mfacton/traction-control/pcb/test-meter/Wiring.png

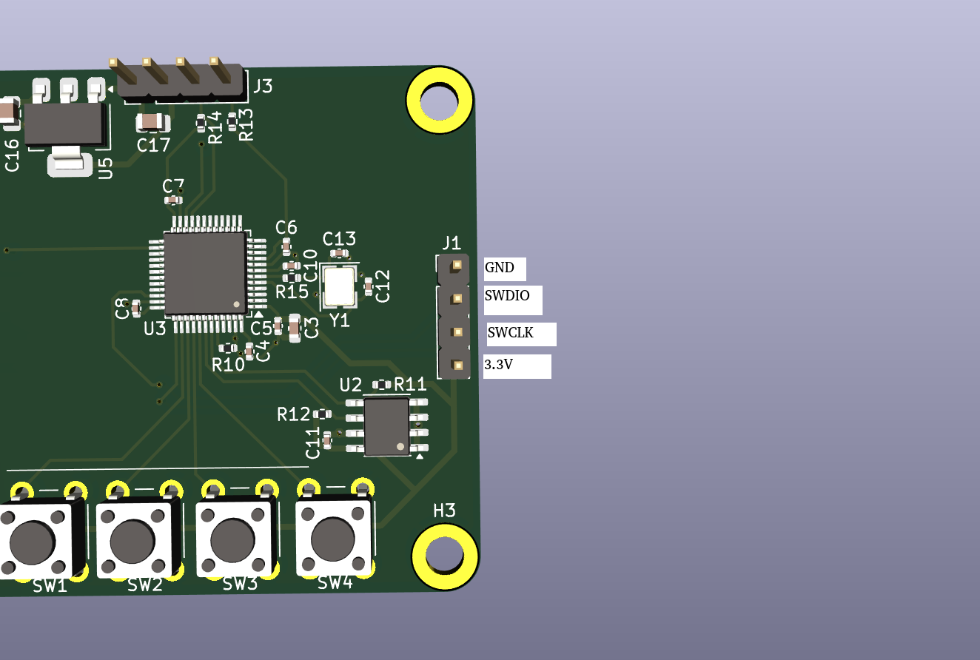
pcb/test-meter/Wiring.png
