mfacton/traction-control/notes.txt

gps should be powered off of 5V
put a diode to not drain the coincell
