mfacton/traction-control/pcb/traction-control/traction-control.kicad_pcb

## KiCad design pcb/traction-control/traction-control.kicad_pcb (2024-07-23)

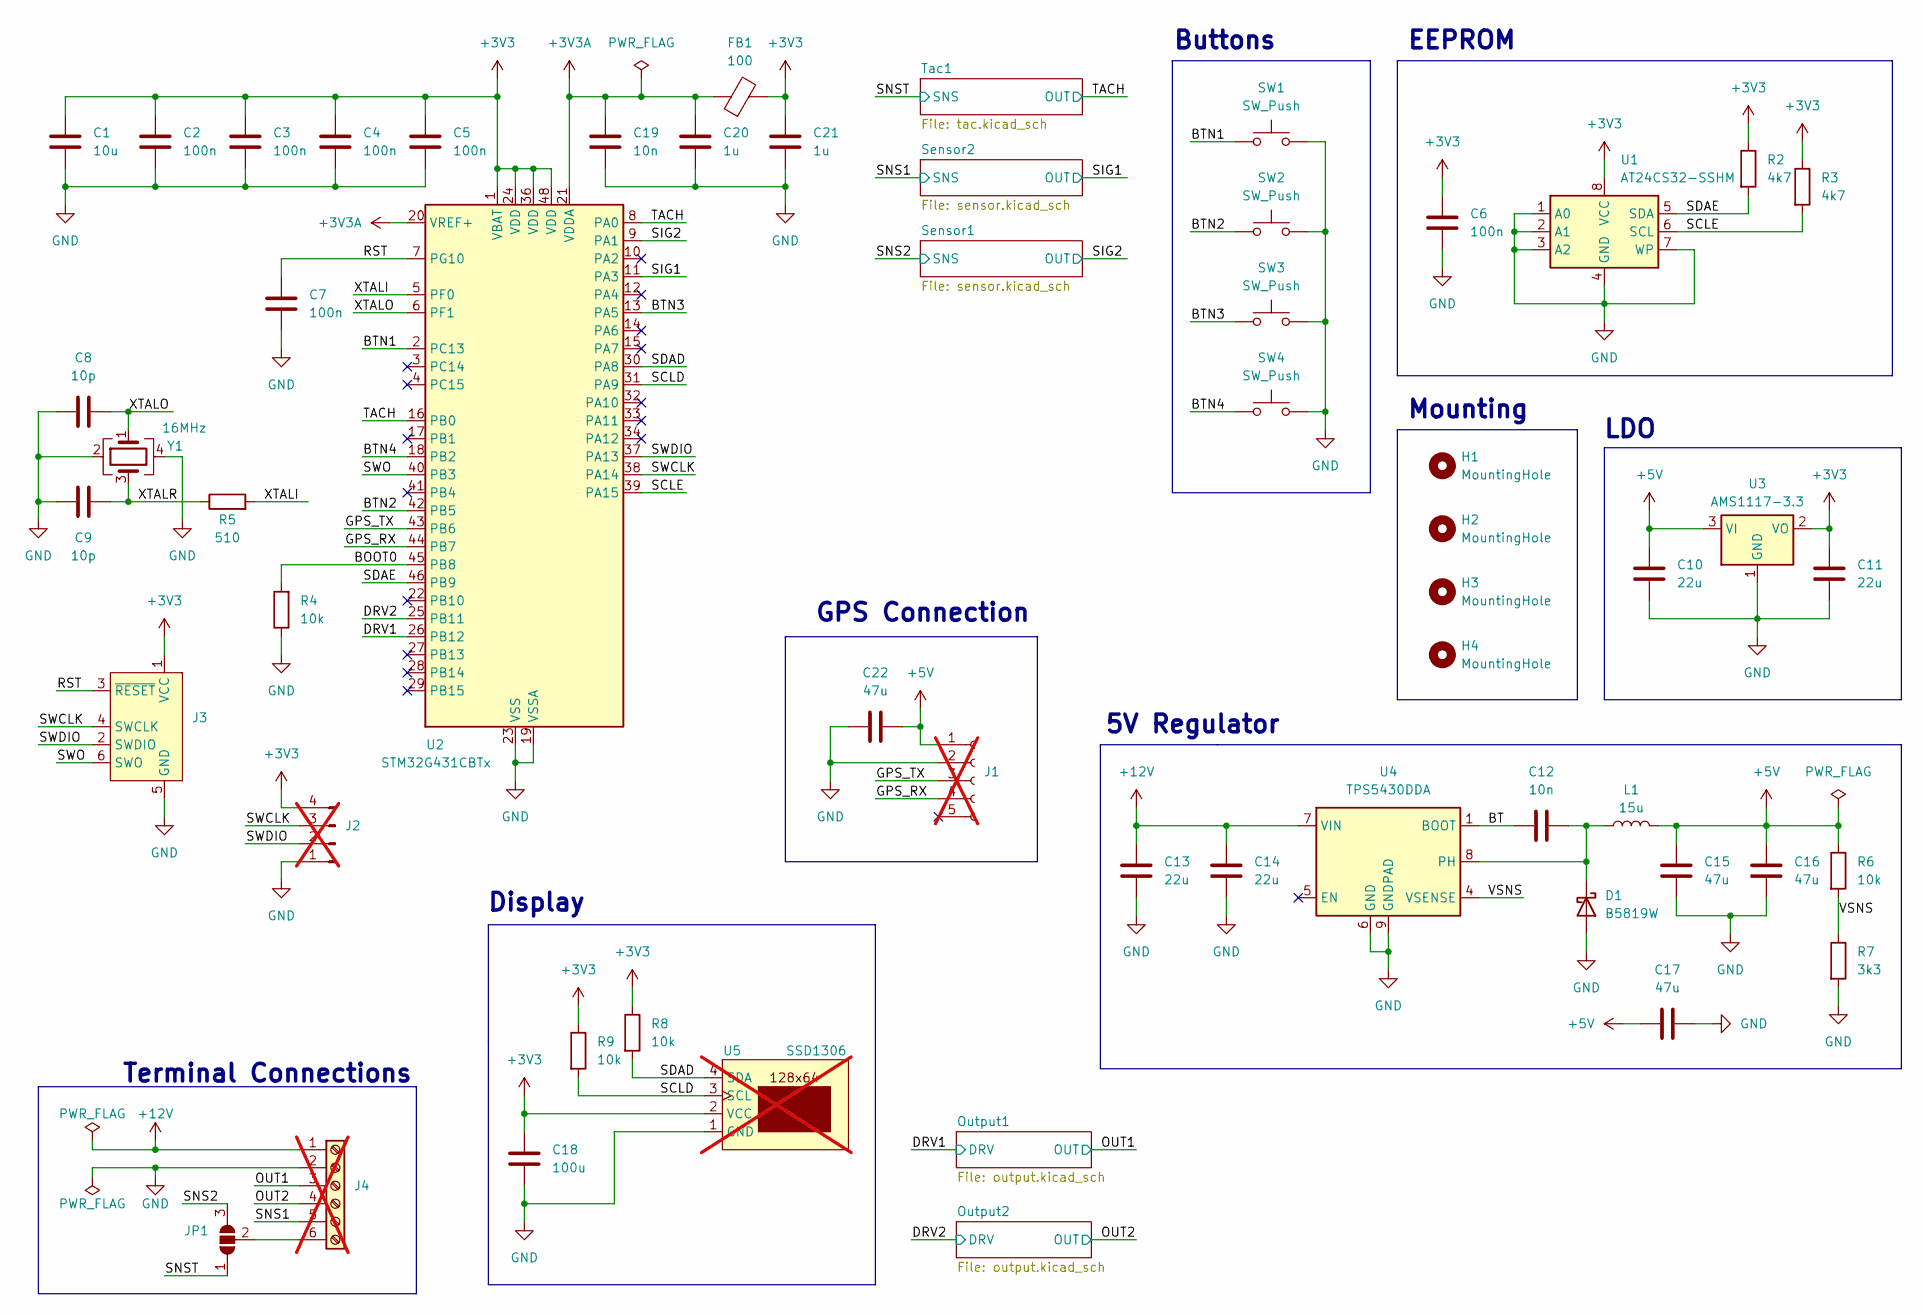
[picture p2: schematic traction-control.kicad_sch]

Parts:
C1: 10u; C_0402_1005Metric; LCSC C15525
C2, C3, C4, C5, C6, C7: 100n; C_0402_1005Metric; LCSC C1525
C8, C9: 10p; C_0402_1005Metric; LCSC C32949
C10: 22u; C_0805_2012Metric; LCSC C45783
C11: 22u; C_0603_1608Metric; LCSC C59461
C12, C19: 10n; C_0402_1005Metric; LCSC C15195
C13, C14: 22u; C_1206_3216Metric; LCSC C12891
C15, C16, C17, C22: 47u; C_1206_3216Metric; LCSC C96123
C18: 100u; C_1206_3216Metric; LCSC C15008
C20, C21: 1u; C_0402_1005Metric; LCSC C52923
D1: B5819W; D_SOD-123; LCSC C8598
FB1: 100; L_0805_2012Metric; LCSC C1015
H1, H2, H3, H4: MountingHole; MountingHole_3.2mm_M3
J1: Conn_01x05_Socket; PinHeader_1x05_P2.54mm_Vertical; not fitted
J2: Conn_01x04_Pin; PinHeader_1x04_P2.54mm_Vertical; not fitted
J3: Conn_ARM_SWD_TagConnect_TC2030-NL; Tag-Connect_TC2030-IDC-NL_2x03_P1.27mm_Vertical
J4: Screw_Terminal_01x06; ScrewTerminalPlug_6P_P5.08; not fitted
JP1: SolderJumper_3_Open; SolderJumper-3_P1.3mm_Open_RoundedPad1.0x1.5mm
L1: 15u; L_Changjiang_FNR6020S; LCSC C168015
R2, R3: 4k7; R_0402_1005Metric; LCSC C25900
R4, R6, R8, R9: 10k; R_0402_1005Metric; LCSC C25744
R5: 510; R_0402_1005Metric; LCSC C25123
R7: 3k3; R_0402_1005Metric; LCSC C25890
SW1, SW2, SW3, SW4: SW_Push; SW_Push_1P1T_NO_6x6mm_H9.5mm; LCSC C455119
U1: AT24CS32-SSHM; SOIC-8_3.9x4.9mm_P1.27mm; LCSC C6482
U2: STM32G431CBTx; LQFP-48_7x7mm_P0.5mm; LCSC C529355
U3: AMS1117-3.3; SOT-223-3_TabPin2; LCSC C6186
U4: TPS5430DDA; TI_SO-PowerPAD-8_ThermalVias; LCSC C9864
U5: SSD1306; SSD1309_1.3; not fitted
Y1: 16MHz; Crystal_SMD_3225-4Pin_3.2x2.5mm; LCSC C13738

Connections:
+3V3: C1.1, C2.1, C3.1, C4.1, C5.1, C6.1, C11.1, C18.1, C21.1, FB1.2, J2.4, J3.1 (VCC), R2.1, R3.1, R8.1, R9.1, U1.8 (VCC), U2.1 (VBAT), U2.24 (VDD), U2.36 (VDD), U2.48 (VDD), U3.2 (VO), U5.2 (VCC)
+3V3A: C19.1, C20.1, FB1.1, U2.20 (VREF+), U2.21 (VDDA)
+5V: C10.1, C15.1, C16.1, C17.1, C22.1, J1.1, L1.2, R6.1, U3.3 (VI)
+12V: C13.1, C14.1, J4.1, U4.7 (VIN); also elsewhere on the board
/BOOT0: R4.2, U2.45 (PB8)
/BT: C12.1, U4.1 (BOOT)
/BTN1: SW1.1, U2.2 (PC13)
/BTN2: SW2.1, U2.42 (PB5)
/BTN3: SW3.1, U2.13 (PA5)
/BTN4: SW4.1, U2.18 (PB2)
/DRV1: U2.26 (PB12); also elsewhere on the board
/DRV2: U2.25 (PB11); also elsewhere on the board
/GPS_RX: J1.4, U2.44 (PB7)
/GPS_TX: J1.3, U2.43 (PB6)
/OUT1: J4.3; also elsewhere on the board
/OUT2: J4.4; also elsewhere on the board
/RST: C7.1, J3.3 (~RESET), U2.7 (PG10)
/SCLD: R9.2, U2.31 (PA9), U5.3 (SCL)
/SCLE: R3.2, U1.6 (SCL), U2.39 (PA15)
/SDAD: R8.2, U2.30 (PA8), U5.4 (SDA)
/SDAE: R2.2, U1.5 (SDA), U2.46 (PB9)
/SIG1: U2.11 (PA3); also elsewhere on the board
/SIG2: U2.9 (PA1); also elsewhere on the board
/SNS1: J4.5; also elsewhere on the board
/SNS2: JP1.3 (B); also elsewhere on the board
/SNST: JP1.1 (A); also elsewhere on the board
/SWCLK: J2.3, J3.4 (SWCLK), U2.38 (PA14)
/SWDIO: J2.2, J3.2 (SWDIO), U2.37 (PA13)
/SWO: J3.6 (SWO), U2.40 (PB3)
/TACH: U2.8 (PA0), U2.16 (PB0); also elsewhere on the board
/VSNS: R6.2, R7.1, U4.4 (VSENSE)
/XTALI: R5.2, U2.5 (PF0)
/XTALO: C8.2, U2.6 (PF1), Y1.1
/XTALR: C9.2, R5.1, Y1.3
GND: C1.2, C2.2, C3.2, C4.2, C5.2, C6.2, C7.2, C8.1, C9.1, C10.2, C11.2, C13.2, C14.2, C15.2, C16.2, C17.2, C18.2, C19.2, C20.2, C21.2, C22.2, D1.2 (A), J1.2, J2.1, J3.5 (GND), J4.2, R4.1, R7.2, SW1.2, SW2.2, SW3.2, SW4.2, U1.1 (A0), U1.2 (A1), U1.3 (A2), U1.4 (GND), U1.7 (WP), U2.19 (VSSA), U2.23 (VSS), U2.35 (VSS), U2.47 (VSS), U3.1 (GND), U4.6 (GND), U4.9 (GNDPAD), U5.1 (GND), Y1.2, Y1.4; also elsewhere on the board
unnamed: C12.2, D1.1 (K), L1.1, U4.8 (PH)
unnamed: J4.6, JP1.2 (C)

Notes on the sheet:
GPS Connection
Mounting
EEPROM
LDO
Terminal Connections
5V Regulator
Display
Buttons

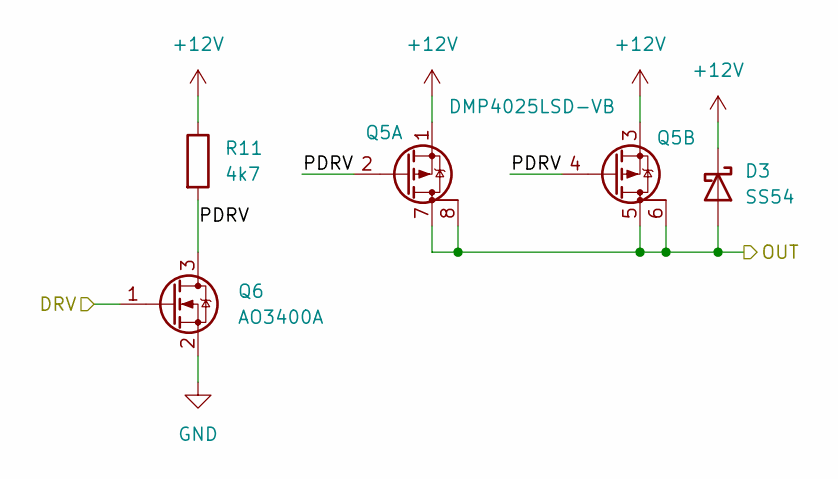
[picture p3: schematic output.kicad_sch]

Parts:
D3: SS54; D_SMA; LCSC C22452
Q5: DMP4025LSD-VB; SOP-8_3.9x4.9mm_P1.27mm; LCSC C725015
Q6: AO3400A; SOT-23; LCSC C20917
R11: 4k7; R_0402_1005Metric; LCSC C25900

Connections:
+12V: D3.1 (K), Q5.1 (S), Q5.3 (S), R11.1; also elsewhere on the board
/DRV2: Q6.1 (G); also elsewhere on the board
/OUT2: D3.2 (A), Q5.5 (D), Q5.6 (D), Q5.7 (D), Q5.8 (D); also elsewhere on the board
/Output2/PDRV: Q5.2 (G), Q5.4 (G), Q6.3 (D), R11.2
GND: Q6.2 (S); also elsewhere on the board

Parts of its further copies:
D2: SS54; D_SMA; LCSC C22452
Q3: DMP4025LSD-VB; SOP-8_3.9x4.9mm_P1.27mm; LCSC C725015
Q4: AO3400A; SOT-23; LCSC C20917
R10: 4k7; R_0402_1005Metric; LCSC C25900

Connections of its further copies:
+12V: D2.1 (K), Q3.1 (S), Q3.3 (S), R10.1; also elsewhere on the board
/DRV1: Q4.1 (G); also elsewhere on the board
/OUT1: D2.2 (A), Q3.5 (D), Q3.6 (D), Q3.7 (D), Q3.8 (D); also elsewhere on the board
/Output1/PDRV: Q3.2 (G), Q3.4 (G), Q4.3 (D), R10.2
GND: Q4.2 (S); also elsewhere on the board

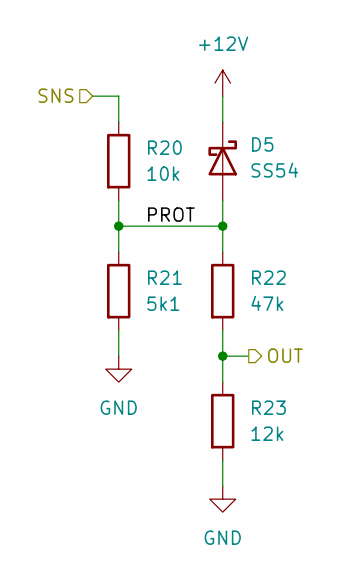
[picture p4: schematic tac.kicad_sch]

Parts:
D5: SS54; D_SMA; LCSC C22452
R20: 10k; R_0402_1005Metric; LCSC C25744
R21: 5k1; R_0402_1005Metric; LCSC C25905
R22: 47k; R_0402_1005Metric; LCSC C25792
R23: 12k; R_0402_1005Metric; LCSC C25752

Connections:
+12V: D5.1 (K); also elsewhere on the board
/SNST: R20.1; also elsewhere on the board
/TACH: R22.2, R23.1; also elsewhere on the board
/Tac1/PROT: D5.2 (A), R20.2, R21.1, R22.1
GND: R21.2, R23.2; also elsewhere on the board

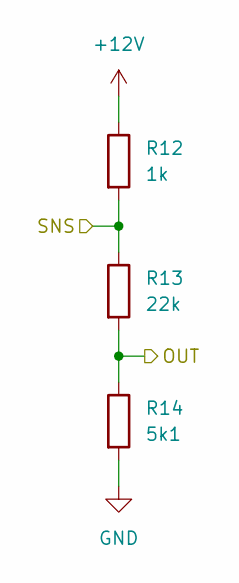
[picture p5: schematic sensor.kicad_sch]

Parts:
R12: 1k; R_1206_3216Metric; LCSC C4410
R13: 22k; R_0402_1005Metric; LCSC C25768
R14: 5k1; R_0402_1005Metric; LCSC C25905

Connections:
+12V: R12.1; also elsewhere on the board
/SIG1: R13.2, R14.1; also elsewhere on the board
/SNS1: R12.2, R13.1; also elsewhere on the board
GND: R14.2; also elsewhere on the board

Parts of its further copies:
R17: 1k; R_1206_3216Metric; LCSC C4410
R18: 22k; R_0402_1005Metric; LCSC C25768
R19: 5k1; R_0402_1005Metric; LCSC C25905

Connections of its further copies:
+12V: R17.1; also elsewhere on the board
/SIG2: R18.2, R19.1; also elsewhere on the board
/SNS2: R17.2, R18.1; also elsewhere on the board
GND: R19.2; also elsewhere on the board

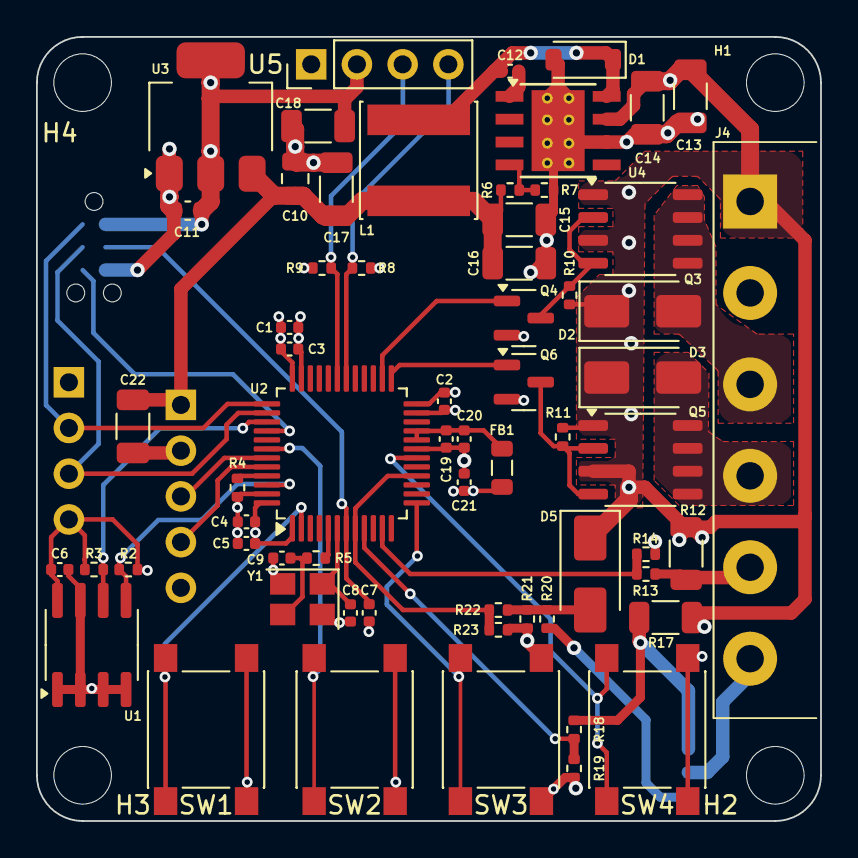
[picture p6: board traction-control.kicad_pcb from above]

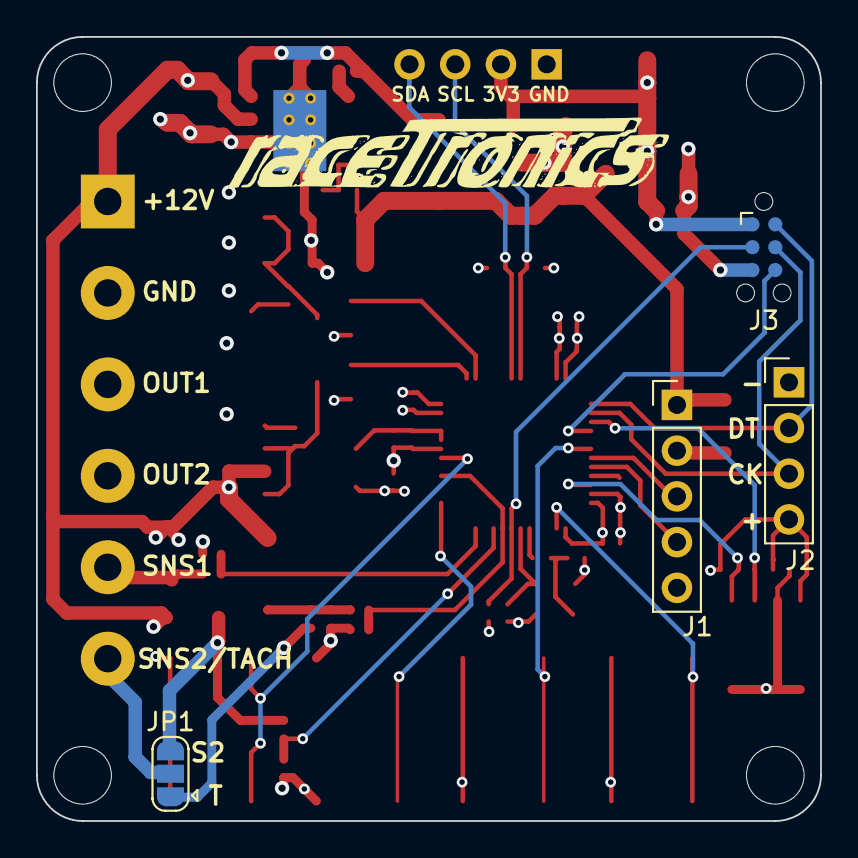
[picture p7: board traction-control.kicad_pcb from below]

Board: 4 copper layers, 43.6 x 43.6 mm, 72 parts (5 on the bottom side), 40 nets.

Other parts of the board:
G1: LOGO
