mfacton/traction-control/pcb/test-meter/test-meter.kicad_pcb

## KiCad design pcb/test-meter/test-meter.kicad_pcb (2024-06-06)

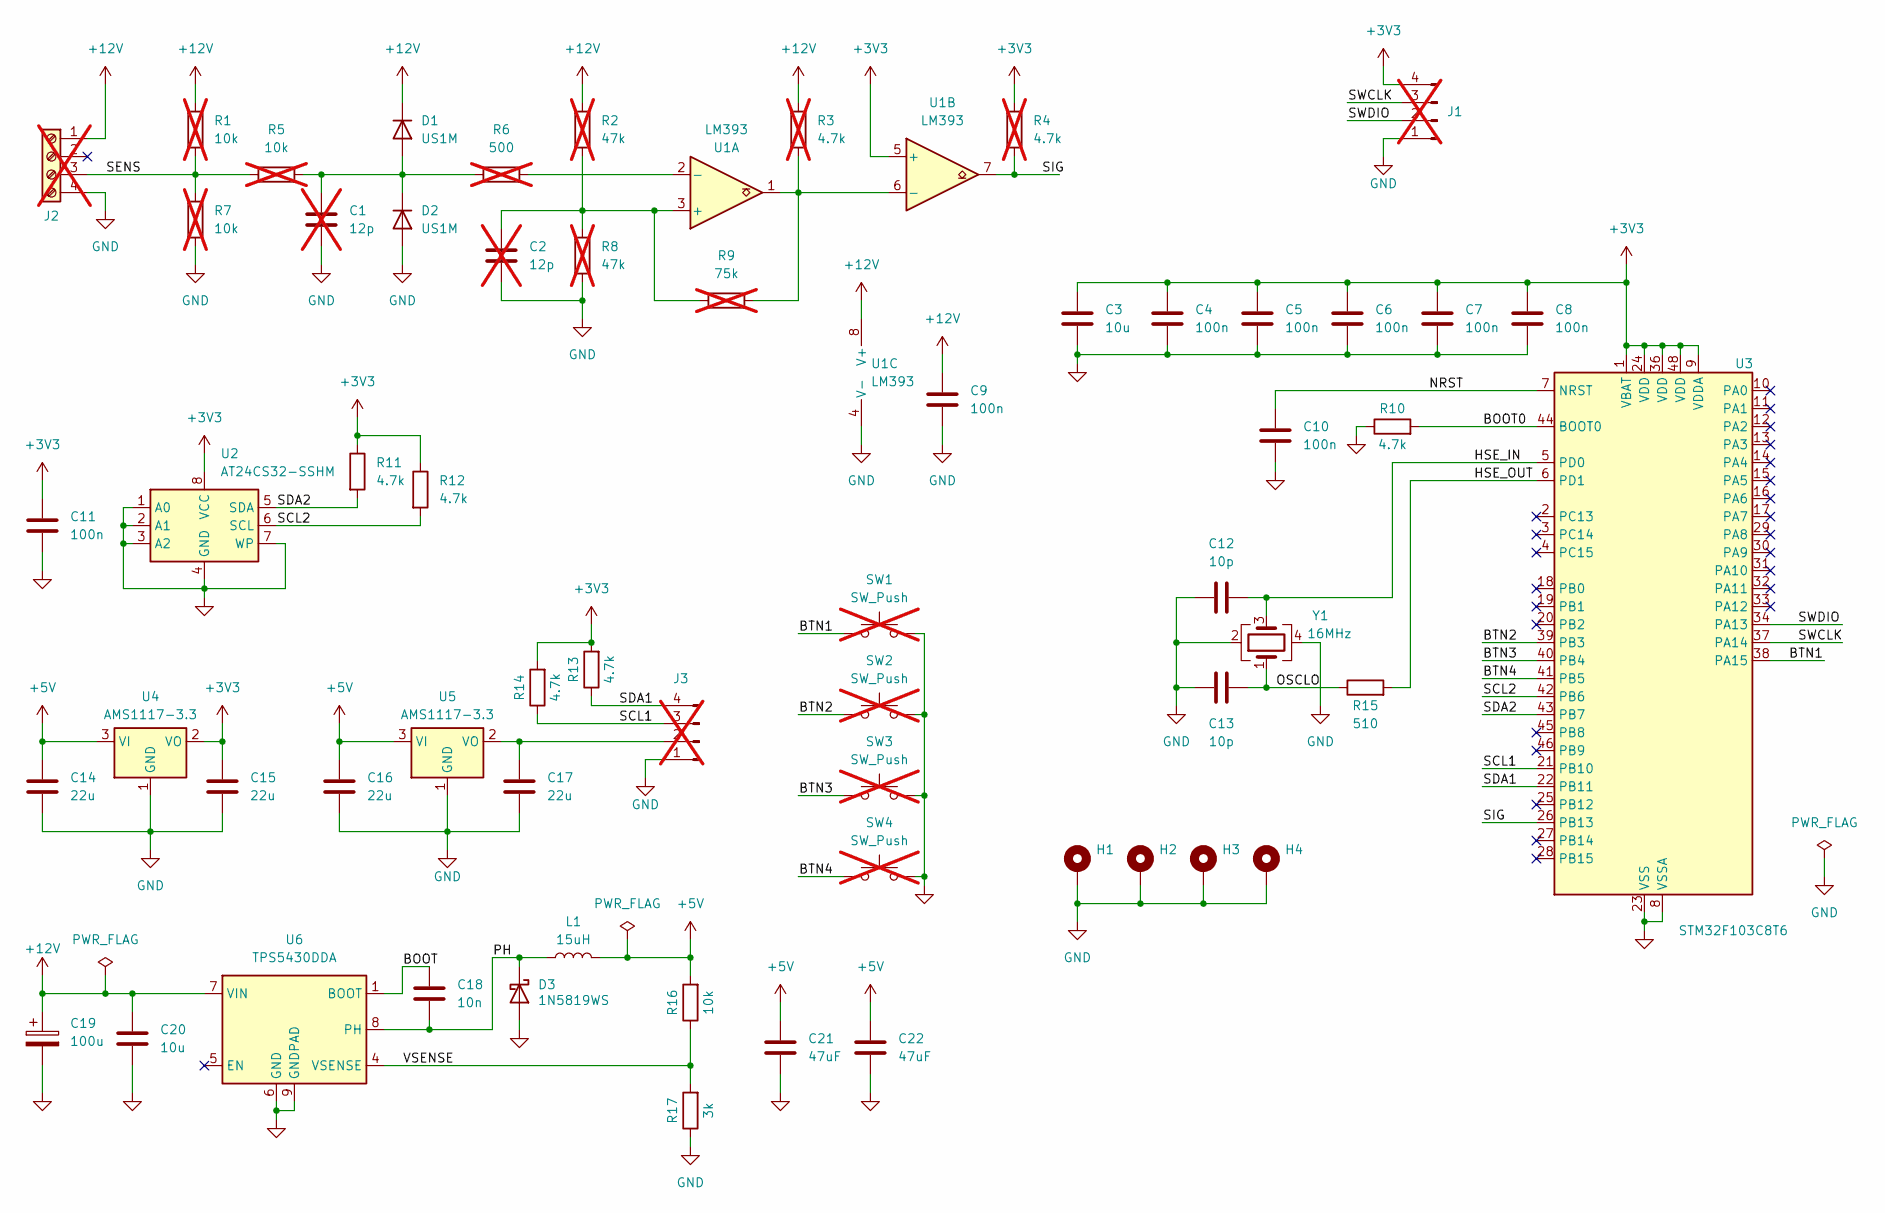
[picture p8: schematic test-meter.kicad_sch]

Parts:
C1, C2: 12p; C_Disc_D5.0mm_W2.5mm_P5.00mm; not fitted
C3: 10u; C_0603_1608Metric
C4, C5, C6, C7, C8, C9, C10, C11: 100n; C_0402_1005Metric
C12, C13: 10p; C_0402_1005Metric
C14, C15, C16, C17: 22u; C_0805_2012Metric
C18: 10n; C_0603_1608Metric
C19: 100u; C_Elec_8x6.2; LCSC C178539
C20: 10u; C_0805_2012Metric
C21, C22: 47uF; C_1206_3216Metric; LCSC C96123
D1, D2: US1M; D_SMA
D3: 1N5819WS; D_SOD-323
H1, H2, H3, H4: MountingHole_Pad; MountingHole_3.2mm_M3_DIN965_Pad
J1, J3: Conn_01x04_Pin; PinHeader_1x04_P2.54mm_Vertical; not fitted
J2: Screw_Terminal_01x04; TerminalBlock_bornier-4_P5.08mm; not fitted
L1: 15uH; L_Changjiang_FNR3010S; LCSC C222856
R1, R5, R7: 10k; R_Axial_DIN0207_L6.3mm_D2.5mm_P10.16mm_Horizontal; LCSC C17902; not fitted
R2, R8: 47k; R_Axial_DIN0207_L6.3mm_D2.5mm_P10.16mm_Horizontal; LCSC C25792; not fitted
R3, R4: 4.7k; R_Axial_DIN0207_L6.3mm_D2.5mm_P10.16mm_Horizontal; not fitted
R6: 500; R_Axial_DIN0207_L6.3mm_D2.5mm_P10.16mm_Horizontal; LCSC C17902; not fitted
R9: 75k; R_Axial_DIN0207_L6.3mm_D2.5mm_P10.16mm_Horizontal; LCSC C25798; not fitted
R10, R11, R12: 4.7k; R_0402_1005Metric; LCSC C25900
R13, R14: 4.7k; R_0402_1005Metric
R15: 510; R_0402_1005Metric; LCSC C25123
R16: 10k; R_0402_1005Metric; LCSC C25744
R17: 3k; R_0603_1608Metric_Pad0.98x0.95mm_HandSolder
SW1, SW2, SW3, SW4: SW_Push; SW_PUSH_6mm; not fitted
U1: LM393; SOIC-8_3.9x4.9mm_P1.27mm; LCSC C7955
U2: AT24CS32-SSHM; SOIC-8_3.9x4.9mm_P1.27mm; LCSC C6482
U3: STM32F103C8T6; LQFP-48_7x7mm_P0.5mm; LCSC C8734
U4, U5: AMS1117-3.3; SOT-223-3_TabPin2
U6: TPS5430DDA; TI_SO-PowerPAD-8_ThermalVias; LCSC C9864
Y1: 16MHz; Crystal_SMD_3225-4Pin_3.2x2.5mm

Connections:
+3V3: C3.1, C4.1, C5.1, C6.1, C7.1, C8.1, C11.1, C15.1, J1.4, R4.1, R11.1, R12.1, R13.2, R14.2, U1.5 (+), U2.8 (VCC), U3.1 (VBAT), U3.9 (VDDA), U3.24 (VDD), U3.36 (VDD), U3.48 (VDD), U4.2 (VO)
+5V: C14.1, C16.1, C21.1, C22.1, L1.2, R16.2, U4.3 (VI), U5.3 (VI)
+12V: C9.1, C19.1, C20.1, D1.1 (K), J2.1, R1.1, R2.1, R3.1, U1.8 (V+), U6.7 (VIN)
/BOOT: C18.1, U6.1 (BOOT)
/BOOT0: R10.2, U3.44 (BOOT0)
/BTN1: SW1.1, U3.38 (PA15)
/BTN2: SW2.1, U3.39 (PB3)
/BTN3: SW3.1, U3.40 (PB4)
/BTN4: SW4.1, U3.41 (PB5)
/HSE_IN: C12.2, U3.5 (PD0), Y1.3
/HSE_OUT: R15.2, U3.6 (PD1)
/NRST: C10.1, U3.7 (NRST)
/OSCLO: C13.2, R15.1, Y1.1
/PH: C18.2, D3.1 (K), L1.1, U6.8 (PH)
/SCL1: J3.3, R14.1, U3.21 (PB10)
/SCL2: R12.2, U2.6 (SCL), U3.42 (PB6)
/SDA1: J3.4, R13.1, U3.22 (PB11)
/SDA2: R11.2, U2.5 (SDA), U3.43 (PB7)
/SENS: J2.3, R1.2, R5.1, R7.1
/SIG: R4.2, U1.7, U3.26 (PB13)
/SWCLK: J1.3, U3.37 (PA14)
/SWDIO: J1.2, U3.34 (PA13)
/VSENSE: R16.1, R17.2, U6.4 (VSENSE)
GND: C1.2, C2.2, C3.2, C4.2, C5.2, C6.2, C7.2, C8.2, C9.2, C10.2, C11.2, C12.1, C13.1, C14.2, C15.2, C16.2, C17.2, C19.2, C20.2, C21.2, C22.2, D2.2 (A), D3.2 (A), H1.1, H2.1, H3.1, H4.1, J1.1, J2.4, J3.1, R7.2, R8.2, R10.1, R17.1, SW1.2, SW2.2, SW3.2, SW4.2, U1.4 (V-), U2.1 (A0), U2.2 (A1), U2.3 (A2), U2.4 (GND), U2.7 (WP), U3.8 (VSSA), U3.23 (VSS), U3.35 (VSS), U3.47 (VSS), U4.1 (GND), U5.1 (GND), U6.6 (GND), U6.9 (GNDPAD), Y1.2, Y1.4
unnamed: C1.1, D1.2 (A), D2.1 (K), R5.2, R6.1
unnamed: C17.1, J3.2, U5.2 (VO)
unnamed: C2.1, R2.2, R8.1, R9.1, U1.3 (+)
unnamed: R6.2, U1.2 (-)
unnamed: R3.2, R9.2, U1.1, U1.6 (-)

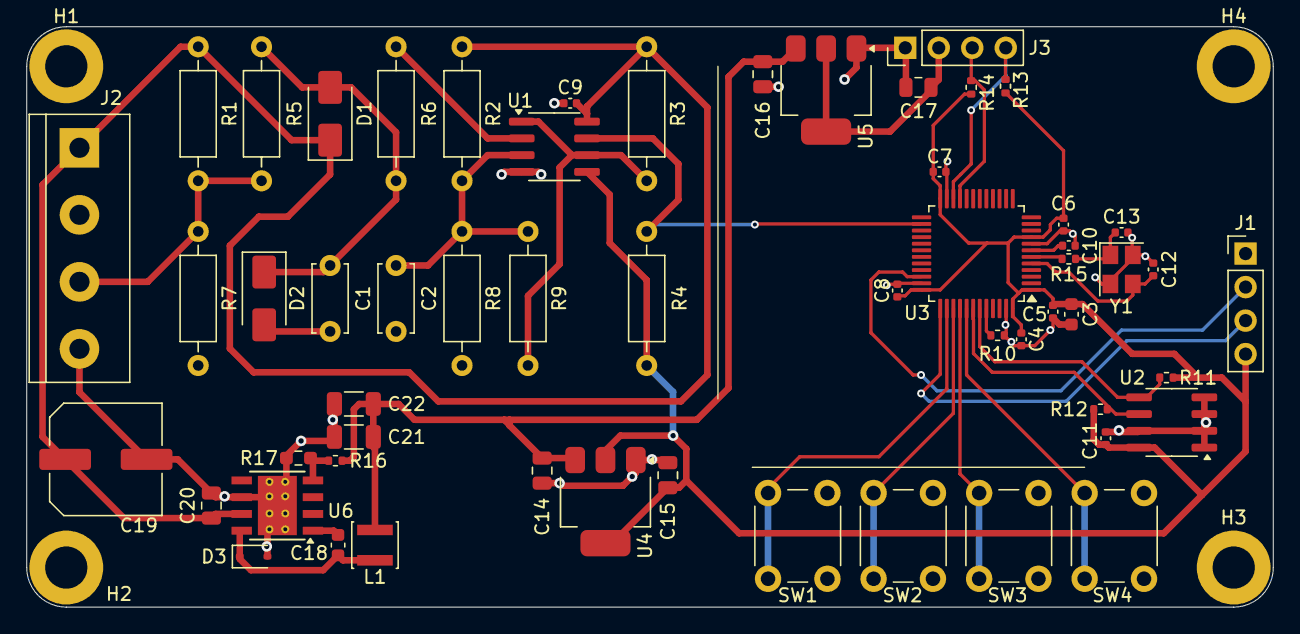
[picture p9: board test-meter.kicad_pcb from above]

Board: 2 copper layers, 94.5 x 44.0 mm, 61 parts (0 on the bottom side), 29 nets.
