mfacton/traction-control/firmware/TractionControl2/TractionControl2.ioc

Mcu.UserName=STM32G431CBTx
PA0.GPIO_Label=TACH
PA0.Signal=COMP3_INP
PA1.GPIO_Label=SIG2
PA1.Signal=COMP1_INP
PA11.GPIO_Label=PGPS
PA11.Signal=GPIO_Output
PA13.Signal=SYS_JTMS-SWDIO
PA14.Signal=SYS_JTCK-SWCLK
PA15.GPIO_Label=SCLE
PA15.Signal=I2C1_SCL
PA3.GPIO_Label=SIG1
PA3.Signal=COMP2_INP
PA5.GPIO_Label=BTN3
PA5.Signal=GPIO_Input
PA8.GPIO_Label=SDAD
PA8.Signal=I2C2_SDA
PA9.GPIO_Label=SCLD
PA9.Signal=I2C2_SCL
PB0.GPIO_Label=TACH
PB0.Signal=COMP4_INP
PB11.GPIO_Label=DRV2
PB11.Signal=GPIO_Output
PB12.GPIO_Label=DRV1
PB12.Signal=GPIO_Output
PB2.GPIO_Label=BTN4
PB2.Signal=GPIO_Input
PB3.Signal=SYS_JTDO-SWO
PB5.GPIO_Label=BTN2
PB5.Signal=GPIO_Input
PB6.GPIO_Label=GPS_TX
PB6.Signal=USART1_TX
PB7.GPIO_Label=GPS_RX
PB7.Signal=USART1_RX
PB9.GPIO_Label=SDAE
PB9.Signal=I2C1_SDA
PC13.GPIO_Label=BTN1
PC13.Signal=GPIO_Input
PF0-OSC_IN.Signal=RCC_OSC_IN
PF1-OSC_OUT.Signal=RCC_OSC_OUT
