mfacton/traction-control/firmware/TractionControl/App/Inc/bitmaps.h

#ifndef INC_BITMAPS_H_
#define INC_BITMAPS_H_

#include <inttypes.h>

const uint8_t bm_logo[] = { 0x00, 0x00, 0x00, 0x00, 0x00, 0x00, 0x00, 0x00,
		0x00, 0x00, 0x00, 0x00, 0x00, 0x00, 0x00, 0x00, 0x00, 0x00, 0x00, 0x00,
		0x00, 0x00, 0x00, 0x3f, 0xff, 0xff, 0xff, 0xff, 0xff, 0x80, 0x00, 0x00,
		0x00, 0x00, 0x00, 0x00, 0x00, 0x00, 0x00, 0x7f, 0xff, 0xff, 0xff, 0xff,
		0xff, 0x00, 0x00, 0x00, 0x00, 0x00, 0x00, 0x00, 0x00, 0x00, 0x00, 0x07,
		0x00, 0x00, 0x00, 0x00, 0x00, 0x00, 0x00, 0x00, 0x00, 0x00, 0x01, 0xc1,
		0xf8, 0x3f, 0x1f, 0x8e, 0x38, 0x3c, 0x3e, 0x1c, 0x7e, 0x3f, 0x00, 0x00,
		0x00, 0x00, 0x01, 0xf3, 0xfc, 0x7e, 0x3f, 0x0e, 0x3e, 0x7e, 0x3f, 0x18,
		0xfc, 0x7e, 0x00, 0x00, 0x00, 0x00, 0x03, 0xf0, 0x1c, 0xe0, 0x70, 0x0c,
		0x7e, 0x66, 0x33, 0x01, 0xc0, 0xc0, 0x00, 0x00, 0x00, 0x00, 0x03, 0x80,
		0x1c, 0xc0, 0x60, 0x1c, 0x70, 0xc6, 0x63, 0x31, 0x80, 0xc0, 0x00, 0x00,
		0x00, 0x00, 0x03, 0x03, 0xf9, 0x80, 0xfe, 0x1c, 0x60, 0xc6, 0x63, 0x33,
		0x00, 0xf0, 0x00, 0x00, 0x00, 0x00, 0x07, 0x07, 0xf9, 0x80, 0xfc, 0x18,
		0xe0, 0xcc, 0x66, 0x73, 0x00, 0x78, 0x00, 0x00, 0x00, 0x00, 0x07, 0x06,
		0x19, 0x80, 0xc0, 0x38, 0xe1, 0x8c, 0xc6, 0x63, 0x00, 0x18, 0x00, 0x00,
		0x00, 0x00, 0x06, 0x0c, 0x33, 0x01, 0x80, 0x38, 0xc1, 0x8c, 0xc6, 0x66,
		0x00, 0x18, 0x00, 0x00, 0x00, 0x00, 0x0e, 0x0c, 0x33, 0x01, 0x80, 0x31,
		0xc1, 0x9c, 0xce, 0xe6, 0x00, 0x38, 0x00, 0x00, 0x00, 0x00, 0x0e, 0x0f,
		0xf3, 0xf9, 0xfc, 0x71, 0xc1, 0xf9, 0xcc, 0xc7, 0xf3, 0xf0, 0x00, 0x00,
		0x00, 0x00, 0x0c, 0x07, 0xe1, 0xf0, 0xf8, 0x71, 0x80, 0xf1, 0x8c, 0xc3,
		0xe7, 0xe0, 0x00, 0x00, 0x00, 0x00, 0x00, 0x00, 0x00, 0x00, 0x00, 0x00,
		0x00, 0x00, 0x00, 0x00, 0x00, 0x00, 0x00, 0x00 };

const uint8_t bm_scroll[] = { 0xfc, 0x84, 0x84, 0x84, 0x84, 0x84, 0x84, 0x84,
		0x84, 0x84, 0x84, 0x84, 0x84, 0x84, 0x84, 0x84, 0x84, 0x84, 0x84, 0x84,
		0x84, 0x84, 0x84, 0x84, 0x84, 0x84, 0x84, 0x84, 0x84, 0x84, 0x84, 0x84,
		0x84, 0x84, 0x84, 0x84, 0x84, 0x84, 0x84, 0x84, 0x84, 0x84, 0x84, 0x84,
		0x84, 0x84, 0x84, 0xfc };

const uint8_t bm_increment[] = {
		0b11111110,
		0b10000010,
};

const uint8_t bm_no_signal[] = {0xbd, 0x42, 0xa5, 0x99, 0x99, 0xa5, 0x42, 0xbd};

const uint8_t bm_signal[] = {0x3c, 0x42, 0x99, 0xbd, 0xbd, 0x99, 0x42, 0x3c};

#endif
