mfacton/traction-control/firmware/TestMeter/Core/Src/main.c

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
/* Includes ------------------------------------------------------------------*/
#include "main.h"

/* USER CODE BEGIN Includes */
#include "control.h"
/* USER CODE END Includes */

I2C_HandleTypeDef hi2c1;
I2C_HandleTypeDef hi2c2;

TIM_HandleTypeDef htim3;
TIM_HandleTypeDef htim4;

void SystemClock_Config(void);
static void MX_GPIO_Init(void);
static void MX_I2C2_Init(void);
static void MX_TIM3_Init(void);
static void MX_TIM4_Init(void);
static void MX_I2C1_Init(void);
/**
  * @brief  The application entry point.
  * @retval int
  */
int main(void)
{

  /* MCU Configuration--------------------------------------------------------*/

  /* Reset of all peripherals, Initializes the Flash interface and the Systick. */
  HAL_Init();

  /* Configure the system clock */
  SystemClock_Config();

  /* Initialize all configured peripherals */
  MX_GPIO_Init();
  MX_I2C2_Init();
  MX_TIM3_Init();
  MX_TIM4_Init();
  MX_I2C1_Init();
  /* USER CODE BEGIN 2 */
	HAL_Delay(1);
	Control_Init();
	HAL_Delay(1);
  /* USER CODE END 2 */

  /* Infinite loop */
  /* USER CODE BEGIN WHILE */

	while (1) {
		Control_Loop();
    /* USER CODE END WHILE */

    /* USER CODE BEGIN 3 */
	}
  /* USER CODE END 3 */
}

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
/* USER CODE BEGIN 4 */
void HAL_TIM_PeriodElapsedCallback(TIM_HandleTypeDef *htim) {
	if (htim == &htim3) {
		TAC_CounterHandler();
	}else if (htim == &htim4){
		TAC_UpdateHandler();
	}
}

void HAL_GPIO_EXTI_Callback(uint16_t GPIO_Pin) {
	TAC_IrqHandler();
}
/* USER CODE END 4 */
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
