mfacton/traction-control/(commit log)

2024-06-06 Add test-meter pcb
    [bom.csv, designators.csv, positions.csv, test-meter.kicad_pcb, test-meter.kicad_sch]
2024-06-06 Ignore stm32 debug
2024-06-06 Add test-meter stm32 code
2024-06-07 Add old documents
    [TractionControl.xlsx, gps_config.txt]
2024-06-10 Setup stm32 project
2024-06-10 Finish placing and route power
    [input.kicad_sch, output.kicad_sch, sensor.kicad_sch, traction-control.kicad_pcb, traction-control.kicad_sch]
2024-06-13 Revision and production files
    [bom.csv, designators.csv, input.kicad_sch, output.kicad_sch, positions.csv, tac.kicad_sch, traction-control.kicad_pcb, traction-control.kicad_sch]
2024-06-23 Add labeling silkmask
    [slc-control.kicad_pcb, slc-control.kicad_sch, traction-control.kicad_pcb]
2024-07-01 Finish schematic except pins
    [output.kicad_sch, sensor.kicad_sch, slc-control.kicad_pcb, slc-control.kicad_sch]
2024-07-05 Final pcb
    [slc-control.kicad_pcb, slc-control.kicad_sch]
2024-07-05 Ignore usb device
2024-07-06 Make production files
    [bom.csv, designators.csv, output.kicad_sch, positions.csv, sensor.kicad_sch, tac.kicad_sch, traction-control.kicad_pcb, traction-control.kicad_sch]
2024-07-07 Finish layout
    [slc-control.kicad_pcb, slc-control.kicad_sch]
2024-07-07 Change extended parts to do not place
    [bom.csv, designators.csv, output.kicad_sch, positions.csv, slc-control.kicad_pcb, slc-control.kicad_sch]
2024-07-07 Final production
    [bom.csv, positions.csv, slc-control.kicad_pcb, slc-control.kicad_sch]
2024-07-14 Fix power connection
    [bom.csv, designators.csv, positions.csv, traction-control.kicad_pcb, traction-control.kicad_sch]
2024-07-23 Change user and drill origins
    [positions.csv, traction-control.kicad_pcb]
2024-07-26 Fix ssd1309 reset input voltage
    [slc-control.kicad_pcb, slc-control.kicad_sch]
2025-01-04 Move slc-control to seperate repo
    [bom.csv, designators.csv, output.kicad_sch, positions.csv, sensor.kicad_sch, slc-control.kicad_pcb, slc-control.kicad_sch]
